melajin/edge_module/edge_module_c/report_ml/README.md

# 보고서 101특징 C 계산

보고서의 선택 축 400점·400 Hz 특징과 네 클래스 마진을 계산하는 묶음이다. `src/ml_reference.c`가 101특징을 만들고 생성 모델 헤더의 계수로 점수를 계산하며, `src/ml_live.c`가 실제 시각을 가진 512표본을 400점으로 보간한다. 점수는 다섯 fold의 평균 선형 SVM 마진이다.

특징 순서와 로그 변환·표준화·계수 접기는 [101특징 상세 해설](../../docs/report-detail/03-ml-model.md), Python 기준은 [ml/report_model/](../../ml/report_model/)에 있다. 20×20 DFT와 생성된 삼각·Hann 표를 사용한다. 최신 확장 `v3_signal.c`의 2×·3×는 보고서 FG 1× 사본과 구분해 제공한다.

| 경로 | 역할 |
|---|---|
| [src/](src/) | 특징·보간·생성 모델 계수·확장 신호 계산 |
| [tools/](tools/) | Python 비교와 모델 계수 내보내기 |
| [verification/](verification/) | 출처 식별과 기존 비교 기록 |

모델 개발 OOF 1,200개 기록의 정확도 93.67%는 보고서의 개발 평가다. 호스트 수치 비교와 실제 입력 가용 상태는 각각의 검사 기록에 연결하며, 생성 모델 출처와 입력 자료 경로를 함께 보존한다.

이 디렉터리의 `python tools/verify_ml.py`는 생성 헤더를 C로 빌드하고 합성 400점 입력의 101특징·네 점수와 상수 입력 상태를 확인한다. 개발 원신호·fold 모델을 이용한 수치 비교는 같은 도구의 입력 인자로 연결한다.
