melajin/edge_module/docs/report-detail/06-results.md

# 6. 평가 결과: 단위·분자·분모와 증거 유형

**보고서 위치:** Ⅳ-1~4(16~19쪽), 표 9~12

CWRU는 분석창 단위, AI-Hub는 파일 단위, B02~B04는 채널별 1.6초 취득 구간 단위로 집계했다. **판정 가능 비율(coverage)**은 유효 판정이 있는 입력의 비율이고, **조건부 탐지율(conditional detection rate)**은 판정 가능한 고장 입력 중 탐지 비율이다. **전체 고장 파일 대비 탐지 비율**은 모든 고장 파일을 분모로 계산한다. 아래 수치는 제출 PDF의 표 9·10 기록이다.

## 보고서 표의 결과

| 평가 경로 | 탐지·오경보 집계 | 판정 가능 비율 | 단위와 집계 규칙 |
|---|---|---|---|
| CWRU 베어링 4상태 분류 | 4/5 확정: 고장 486/486창 탐지, 정상 0/114창 확정 오경보 | 600/640창 = 93.75% | 창 단위. 파일마다 첫 4창을 투표 이력에 넣었으며 $4\times10=40$창 이후 4/5 상태를 집계한다. |
| AI-Hub 베어링 V2 순간 판정 | 판정 가능 고장 파일 20,547/20,547 탐지 = 100% | 20,547/25,060파일 = 81.99% | 파일별 마지막 유효 판정; 4,513파일은 `unavailable` 상태 |
| AI-Hub 축 정렬 불량 V2 + 4/5 | 판정 가능 고장 파일 8,534/9,108 탐지 = 93.70%; 전체 고장 파일 8,534/22,795 탐지 = 37.44% | 9,108/22,795파일 = 39.96% | 파일별 마지막 확정 판정; 7개 설비 그룹 중 2개는 가용 파일 0개, 한 그룹은 318개 가용 파일에서 탐지 0건 |
| AI-Hub 벨트 느슨함 V2 + 4/5 | 판정 가능 고장 파일 10,218/11,677 탐지 = 87.51%; 전체 고장 파일 10,218/16,343 탐지 = 62.52%; 정상 오경보 538/9,283 = 5.80% | 고장 파일 11,677/16,343 = 71.45% | 파일별 마지막 확정 판정; 정상 오경보 분모는 판정 가능 정상 파일 9,283개 |
| B02~B04 AC RMS + 4/5 | 초기 구간 대리 정상 0/261, 말기 구간 대리 열화 261/261 | 채널별 522/546 취득 구간 | 1.6초 구간, 기록 시각으로 붙인 대리 라벨; 평가 구간 구성은 B02~B04다 |

## 시간 이력 투표 정책

보고서 표 10은 4/5 정책과 20-window 정책의 파일 집계를 비교한다.

| 지표 | 기존 4/5 규칙 | 20창 반복 확인 규칙 |
|---|---:|---:|
| 판정 가능한 결함 파일의 탐지율 | $10,218/11,677=87.51\%$ | $9,790/10,806=90.60\%$ |
| 전체 결함 파일 대비 탐지 비율 | $10,218/16,343=62.52\%$ | $9,790/16,343=59.90\%$ |
| 판정 가능한 결함 파일 | 11,677파일 | 10,806파일 |
| 결함 파일 판정 가능 비율 | $11,677/16,343=71.45\%$ | $10,806/16,343\approx66.12\%$ |
| 정상 오경보율 | $538/9,283=5.80\%$ | $884/7,814=11.31\%$ |

20창 규칙은 조건부 탐지율 90.60%, 전체 고장 파일 대비 탐지 비율 59.90%, 판정 가능 파일 10,806개를 기록한다. 4/5 규칙은 각각 87.51%, 62.52%, 11,677개다. 20창 규칙의 판정 가능 고장 파일은 871개, 탐지 파일은 428개 적고, 정상 오경보율은 11.31%다. PDF 표 10은 기존 4/5 정책을 선택했다.

## 4상태 ML 개발 결과와 모델 범위

보고서 ML 절은 Mendeley Mechanical faults 자료의 20개 trial-group을 나눈 5개 fold OOF 평가로 전체 정확도 93.67%, 축 정렬 재현율 86.00%, 기계적 이완 재현율 88.67%를 기록한다. 이 결과는 해당 공개 자료·profile·101특징·모델의 개발 평가값이다.

현재 로컬 export는 다섯 LinearSVC fold의 평균 마진 후보를 제공한다. provenance 필드는 `ensemble_evaluated=false`, `live_validated=false`이며, 네 클래스는 불평형·기계적 이완·축 정렬 불량·정상이다. 실시간 입력 계약은 ADXL345 한 축·512 표본·380~420 Hz·400점 보간·FG RPM으로 구성된다.

## 기록된 소프트웨어·빌드·모델 결과

보고서 19쪽은 Python/C 투표 parity 219건, Python 검사 36건·23개 하위 케이스, C 합성·엄격 컴파일 검사, ESP32 빌드, CWRU 호스트 재생을 기록한다. CWRU 특징·점수 parity는 640창 전체에서 최대 절대차 2.984×10⁻¹³ 및 4.334×10⁻¹³으로 기록됐다. 세부 클래스 정답은 581/640(90.78%)이고, 4/5 투표는 파일별 첫 4창×10파일=40창을 투표 초기 이력으로 사용해 600창에서 집계했다.

ESP32 두 빌드의 링크 결과는 정적 RAM과 플래시 사용량으로 기록돼 있다.

| 빌드 | 정적 RAM | 플래시 | 기록 유형 |
|---|---:|---:|---|
| FG V3 보고서 검증 펌웨어 | 100,380 / 327,680 byte (30.6%) | 320,561 / 1,310,720 byte (24.5%) | FG V3 타깃 펌웨어 링크 결과 |
| CWRU 전체 통합 펌웨어 | 105,308 / 327,680 byte | 375,349 / 1,310,720 byte | CWRU 기능을 포함한 별도 ESP32 통합 빌드 |

두 행은 컴파일·링크 시점의 정적 RAM·플래시 사용량이며 CWRU 저장 파형의 재생은 호스트 기록에 포함된다.

## 입력 자료별 평가 유형

| 자료 경로 | 평가 단위 | 라벨·결과 유형 |
|---|---|---|
| AI-Hub 베어링·정렬·벨트 | 파일 | 파일별 마지막 유효/확정 결과 |
| CWRU | 4,096표본 분석창 | 파일별 4/5 투표 및 4상태 분류 |
| B02~B04 | 채널별 1.6초 구간 | 초기·말기 시각 구간 대리 라벨 |
| Mendeley v3 | trial-group 분할 OOF 기록 | 101특징 네 클래스 개발 평가 |
| 정상 팬 | 336개 관측 창 | 1× 회전 동기 반복성 기록 |

## 근거 파일

- 원 수치: 제출 최종보고서 16~19쪽 표 9~12.
- CWRU 호스트 재생·결과: 현재 위치 `edge_module_c/report_cwru/verification/result.json`, 창별 입력 `locked_windows.csv`; 통합 설명 `reports/2026-10-01-cwru-firmware-integration-ko.md`.
- B02~B04 시간 구간 대리 라벨 평가 요약: 현재 위치 `reports/2026-09-23-b01-b04-ac-rms-bearing-ko.md`, `reports/final-report-evidence/faults.md`.
- 4상태 모델 평가와 입력별 계산 경로는 [학습 모델](03-ml-model.md), 상세 인용은 [출처와 코드 대응표](08-sources.md)를 참조한다.
