melajin/edge_module/(commit log)

2026-09-16 docs: 합의한 시스템 구조와 구현 상태로 README 정리
2026-10-04 docs: 보고서 기준 상세 해설과 수식·코드 연결 추가
2026-10-04 docs: 기존 README를 보고서와 현재 구현 기준으로 최신화
2026-10-05 feat: 보고서 기준 ADXL345 FG 구현과 기존 자료 정합화
2026-10-08 Add approved baseline lifecycle and ESP32 installation packaging
2026-11-10 Add experiment record and turn README into an entry point
    - docs/experiments.md: per-experiment method, verified facts, unverified scope, evidence
    - README.md: what it is, current status, where to look
    - ml/README.md, edge_module_c/README.md: replace duplicated result tables with links
    - report-detail/ chapters are unchanged
2026-11-11 docs: README에 한눈에 보기와 다음 단계 섹션 추가
    Claude-Session: https://claude.ai/code/session_01RNcv5hs6fLjEx1JbJmk24c
